steveed/a1200kb-external-case/docs/images/case-rear-db37.png

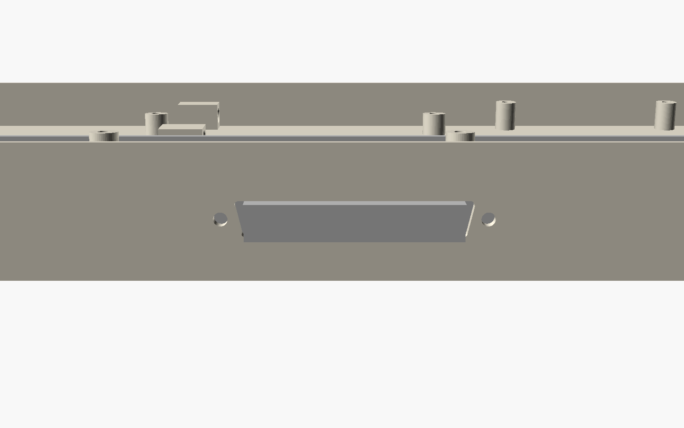
docs/images/case-rear-db37.png
