steveed/a1200kb-external-case/din5/fab/A1200KB-DIN5-bom.csv

Comment | Designator | Footprint | LCSC Part # | MPN
1uF | C1 | Capacitor_SMD:C_0603_1608Metric | C15849 | CL10A105KB8NNNC
100nF | C2 | Capacitor_SMD:C_0603_1608Metric | C14663 | CC0603KRX7R9BB104
PESD5V0S1BA | D1,D2 | Diode_SMD:D_SOD-323 | C19224 | PESD5V0S1BA,115
PTC 500mA hold | F1 | Fuse:Fuse_1206_3216Metric | C69688 | nSMD050
to A1200 CN17 | J1 | Connector_PinHeader_2.54mm:PinHeader_1x07_P2.54mm_Vertical | C492406 | PZ254V-11-07P
Amiga keyboard | J2 | A1200KB:DIN-5_180deg_DIN-504_Horizontal | C23689428 | DIN-504
220k | R1 | Resistor_SMD:R_0603_1608Metric | C22961 | 0603WAF2203T5E
1k | R2 | Resistor_SMD:R_0603_1608Metric | C21190 | 0603WAF1001T5E
74LVC1G14 | U1 | Package_TO_SOT_SMD:SOT-353_SC-70-5 | C265125 | 74LVC1G14GW,125
