steveed/a1200kb-external-case/encoder/fab/A1200KB-Encoder-bom.csv

Comment | Designator | Footprint | LCSC Part # | MPN
100nF | C1,C2,C3 | Capacitor_SMD:C_0603_1608Metric | C14663 | CC0603KRX7R9BB104
10uF | C4 | Capacitor_SMD:C_0805_2012Metric | C15850 | CL21A106KAYNNNE
PESD5V0S1BA | D1,D2 | Diode_SMD:D_SOD-323 | C19224 | PESD5V0S1BA,115
KB FFC | J1 | Amiga_FFC:FFC-1.25mm-RA-5204403245 |  | 52044-3245
LED HDR (symmetric) | J2 | Connector_PinHeader_2.54mm:PinHeader_1x05_P2.54mm_Horizontal | C32713264 | HX PZ2.54-1x5P WZ
Amiga keyboard | J3 | A1200KB:DIN-5_180deg_DIN-504_Horizontal | C23689428 | DIN-504
100 | R1,R2 | Resistor_SMD:R_0603_1608Metric | C22775 | 0603WAF1000T5E
10k | R3,R4 | Resistor_SMD:R_0603_1608Metric | C25804 | 0603WAF1002T5E
150 | R5 | Resistor_SMD:R_0603_1608Metric | C22808 | 0603WAF1500T5E
ATmega4809 | U1 | Package_QFP:TQFP-48_7x7mm_P0.5mm | C189475 | ATMEGA4809-AFR
