steveed/a1200kb-external-case/case/stl/tray_right.stl

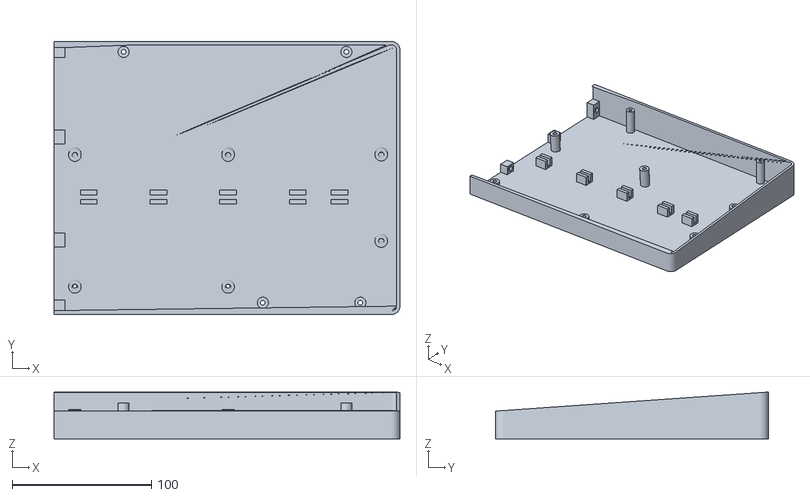
[picture p14: CAD file, 2026-10-28]
case/stl/tray_right.stl
248.5 x 195.9 x 33.7
