steveed/a1200kb-external-case/case/stl/lid_right.stl

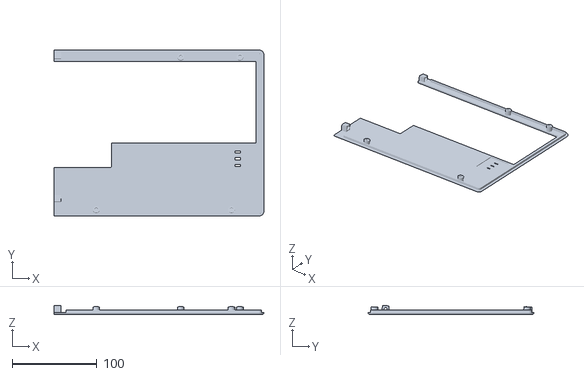
[picture p15: CAD file, 2026-10-28]
case/stl/lid_right.stl
248.5 x 196.4 x 10.9
