steveed/a1200kb-external-case/case/stl/tray_left-din5.stl

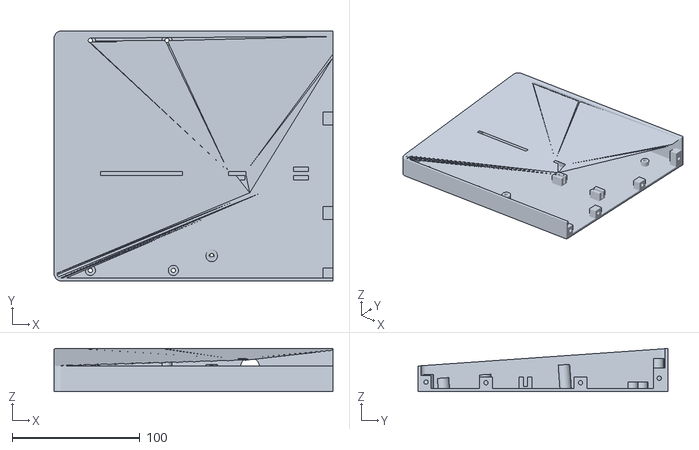
[picture p16: CAD file, 2026-10-28]
case/stl/tray_left-din5.stl
218.5 x 195.9 x 33.7
