steveed/a1200kb-external-case/case/stl/lid_left.stl

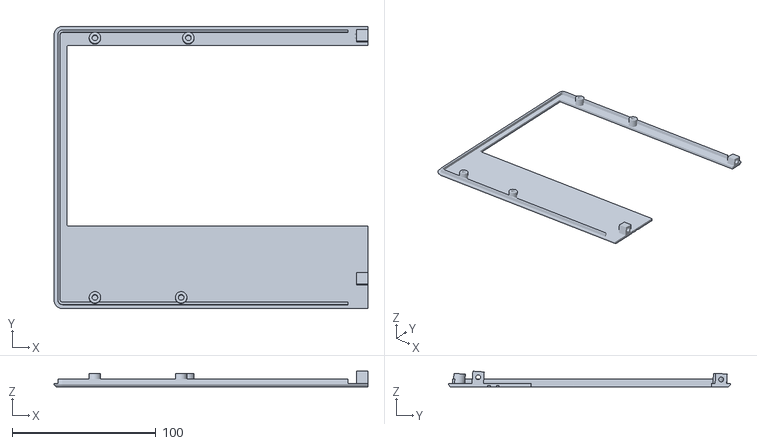
[picture p17: CAD file, 2026-10-28]
case/stl/lid_left.stl
218.5 x 196.4 x 10.9
