steveed/a1200kb-external-case/case/stl/spacers.stl

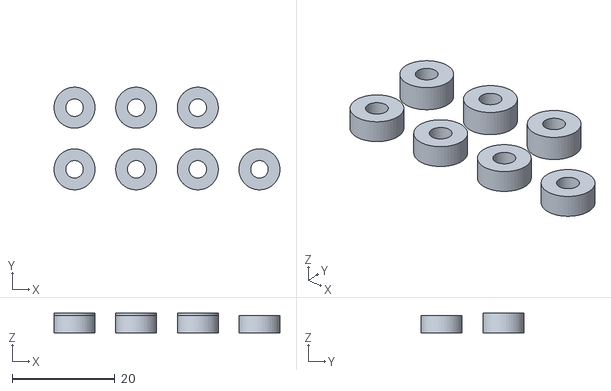
[picture p18: CAD file, 2026-10-28]
case/stl/spacers.stl
44.0 x 20.0 x 3.80
