steveed/a1200kb-external-case/case/kbv2-keys.scad

// A1200KBv2 keycaps: [x, y, width units, height units, iso] in the KBv2 PCB's KiCad coordinates.
// Generated from ../A1200KBv2/A1200KBv2.kicad_pcb (switch footprint positions and unit sizes); preview only.
kb_caps = [
    [81.91, 50.4, 1.25, 1, 0],   // K11
    [105.72, 50.51, 1.25, 1, 0],   // K17
    [153.47, 50.51, 1.25, 1, 0],   // K27
    [177.35, 50.51, 1.25, 1, 0],   // K33
    [209.86, 50.51, 1.25, 1, 0],   // K42
    [233.74, 50.51, 1.25, 1, 0],   // K51
    [257.61, 50.51, 1.25, 1, 0],   // K56
    [281.49, 50.51, 1.25, 1, 0],   // K62
    [305.37, 50.51, 1.25, 1, 0],   // K68
    [129.6, 50.54, 1.25, 1, 0],   // K22
    [50.86, 50.61, 1, 1, 0],   // K1
    [421.56, 79.07, 1, 1, 0],   // K79
    [440.61, 79.07, 1, 1, 0],   // K84
    [459.66, 79.07, 1, 1, 0],   // K88
    [478.71, 79.07, 1, 1, 0],   // K93
    [359.56, 79.11, 1.5, 1, 0],   // K74
    [388.15, 79.11, 1.5, 1, 0],   // K77
    [55.53, 79.17, 1.5, 1, 0],   // K2
    [79.31, 79.17, 1, 1, 0],   // K7
    [98.36, 79.17, 1, 1, 0],   // K13
    [117.41, 79.17, 1, 1, 0],   // K18
    [136.46, 79.17, 1, 1, 0],   // K23
    [155.51, 79.17, 1, 1, 0],   // K28
    [174.56, 79.17, 1, 1, 0],   // K34
    [193.61, 79.17, 1, 1, 0],   // K38
    [212.66, 79.17, 1, 1, 0],   // K43
    [231.71, 79.17, 1, 1, 0],   // K47
    [250.76, 79.17, 1, 1, 0],   // K52
    [269.81, 79.17, 1, 1, 0],   // K57
    [288.86, 79.17, 1, 1, 0],   // K63
    [307.91, 79.17, 1, 1, 0],   // K69
    [326.96, 79.17, 1, 1, 0],   // K72
    [421.56, 98.12, 1, 1, 0],   // K80
    [440.61, 98.12, 1, 1, 0],   // K85
    [459.66, 98.12, 1, 1, 0],   // K89
    [478.71, 98.12, 1, 1, 0],   // K94
    [60.26, 98.22, 2, 1, 0],   // K3
    [88.7, 98.22, 1, 1, 0],   // K8
    [107.75, 98.22, 1, 1, 0],   // K14
    [126.8, 98.22, 1, 1, 0],   // K19
    [145.85, 98.22, 1, 1, 0],   // K24
    [183.95, 98.22, 1, 1, 0],   // K35
    [203.0, 98.22, 1, 1, 0],   // K39
    [222.05, 98.22, 1, 1, 0],   // K44
    [241.1, 98.22, 1, 1, 0],   // K48
    [260.15, 98.22, 1, 1, 0],   // K53
    [279.2, 98.22, 1, 1, 0],   // K58
    [298.25, 98.22, 1, 1, 0],   // K64
    [164.9, 98.3, 1, 1, 0],   // K29
    [324.67, 107.87, 1.5, 2, 1],   // K71
    [421.56, 117.17, 1, 1, 0],   // K81
    [440.61, 117.17, 1, 1, 0],   // K86
    [459.66, 117.17, 1, 1, 0],   // K90
    [478.71, 117.17, 1, 1, 0],   // K95
    [373.88, 117.22, 1, 1, 0],   // K75
    [53.14, 117.27, 1.25, 1, 0],   // K4
    [74.48, 117.27, 1, 1, 0],   // K9
    [93.53, 117.27, 1, 1, 0],   // K15
    [112.58, 117.27, 1, 1, 0],   // K20
    [131.63, 117.27, 1, 1, 0],   // K25
    [150.68, 117.27, 1, 1, 0],   // K30
    [169.73, 117.27, 1, 1, 0],   // K36
    [188.78, 117.27, 1, 1, 0],   // K40
    [207.83, 117.27, 1, 1, 0],   // K45
    [226.88, 117.27, 1, 1, 0],   // K49
    [245.93, 117.27, 1, 1, 0],   // K54
    [265.23, 117.27, 1, 1, 0],   // K59
    [284.28, 117.27, 1, 1, 0],   // K65
    [303.33, 117.27, 1, 1, 0],   // K70
    [421.56, 136.22, 1, 1, 0],   // K82
    [440.61, 136.22, 1, 1, 0],   // K87
    [459.66, 136.22, 1, 1, 0],   // K91
    [354.83, 136.27, 1, 1, 0],   // K73
    [373.88, 136.27, 1, 1, 0],   // K76
    [392.93, 136.27, 1, 1, 0],   // K78
    [57.97, 136.32, 1.75, 1, 0],   // K5
    [84.13, 136.32, 1, 1, 0],   // K10
    [103.18, 136.32, 1, 1, 0],   // K16
    [122.23, 136.32, 1, 1, 0],   // K21
    [141.28, 136.32, 1, 1, 0],   // K26
    [160.33, 136.32, 1, 1, 0],   // K31
    [179.38, 136.32, 1, 1, 0],   // K37
    [198.43, 136.32, 1, 1, 0],   // K41
    [217.48, 136.32, 1, 1, 0],   // K46
    [236.54, 136.32, 1, 1, 0],   // K50
    [274.63, 136.32, 1, 1, 0],   // K60
    [310.45, 136.32, 2, 1, 0],   // K66
    [255.58, 136.34, 1, 1, 0],   // K55
    [478.71, 145.77, 1, 2, 0],   // K96
    [66.86, 155.37, 1.25, 1, 0],   // K6
    [90.74, 155.37, 1.25, 1, 0],   // K12
    [188.4, 155.37, 8, 1, 0],   // K32
    [286.06, 155.37, 1.25, 1, 0],   // K61
    [309.94, 155.37, 1.25, 1, 0],   // K67
    [431.21, 155.37, 2, 1, 0],   // K83
    [459.66, 155.37, 1, 1, 0]    // K92
];
