steveed/a1200kb-external-case/(list of files, cad)

Other CAD files:
case/stl/tray_left.stl
