steveed/a1200kb-external-case/case/stl/assembly.png

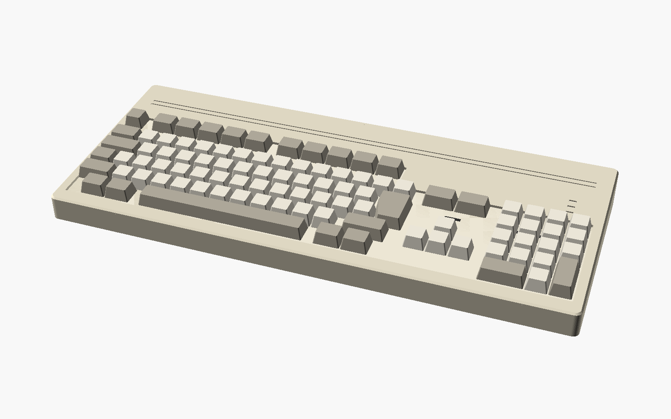
case/stl/assembly.png
