steveed/a1200kb-external-case/adapter/A1200KB-DB37.pdf

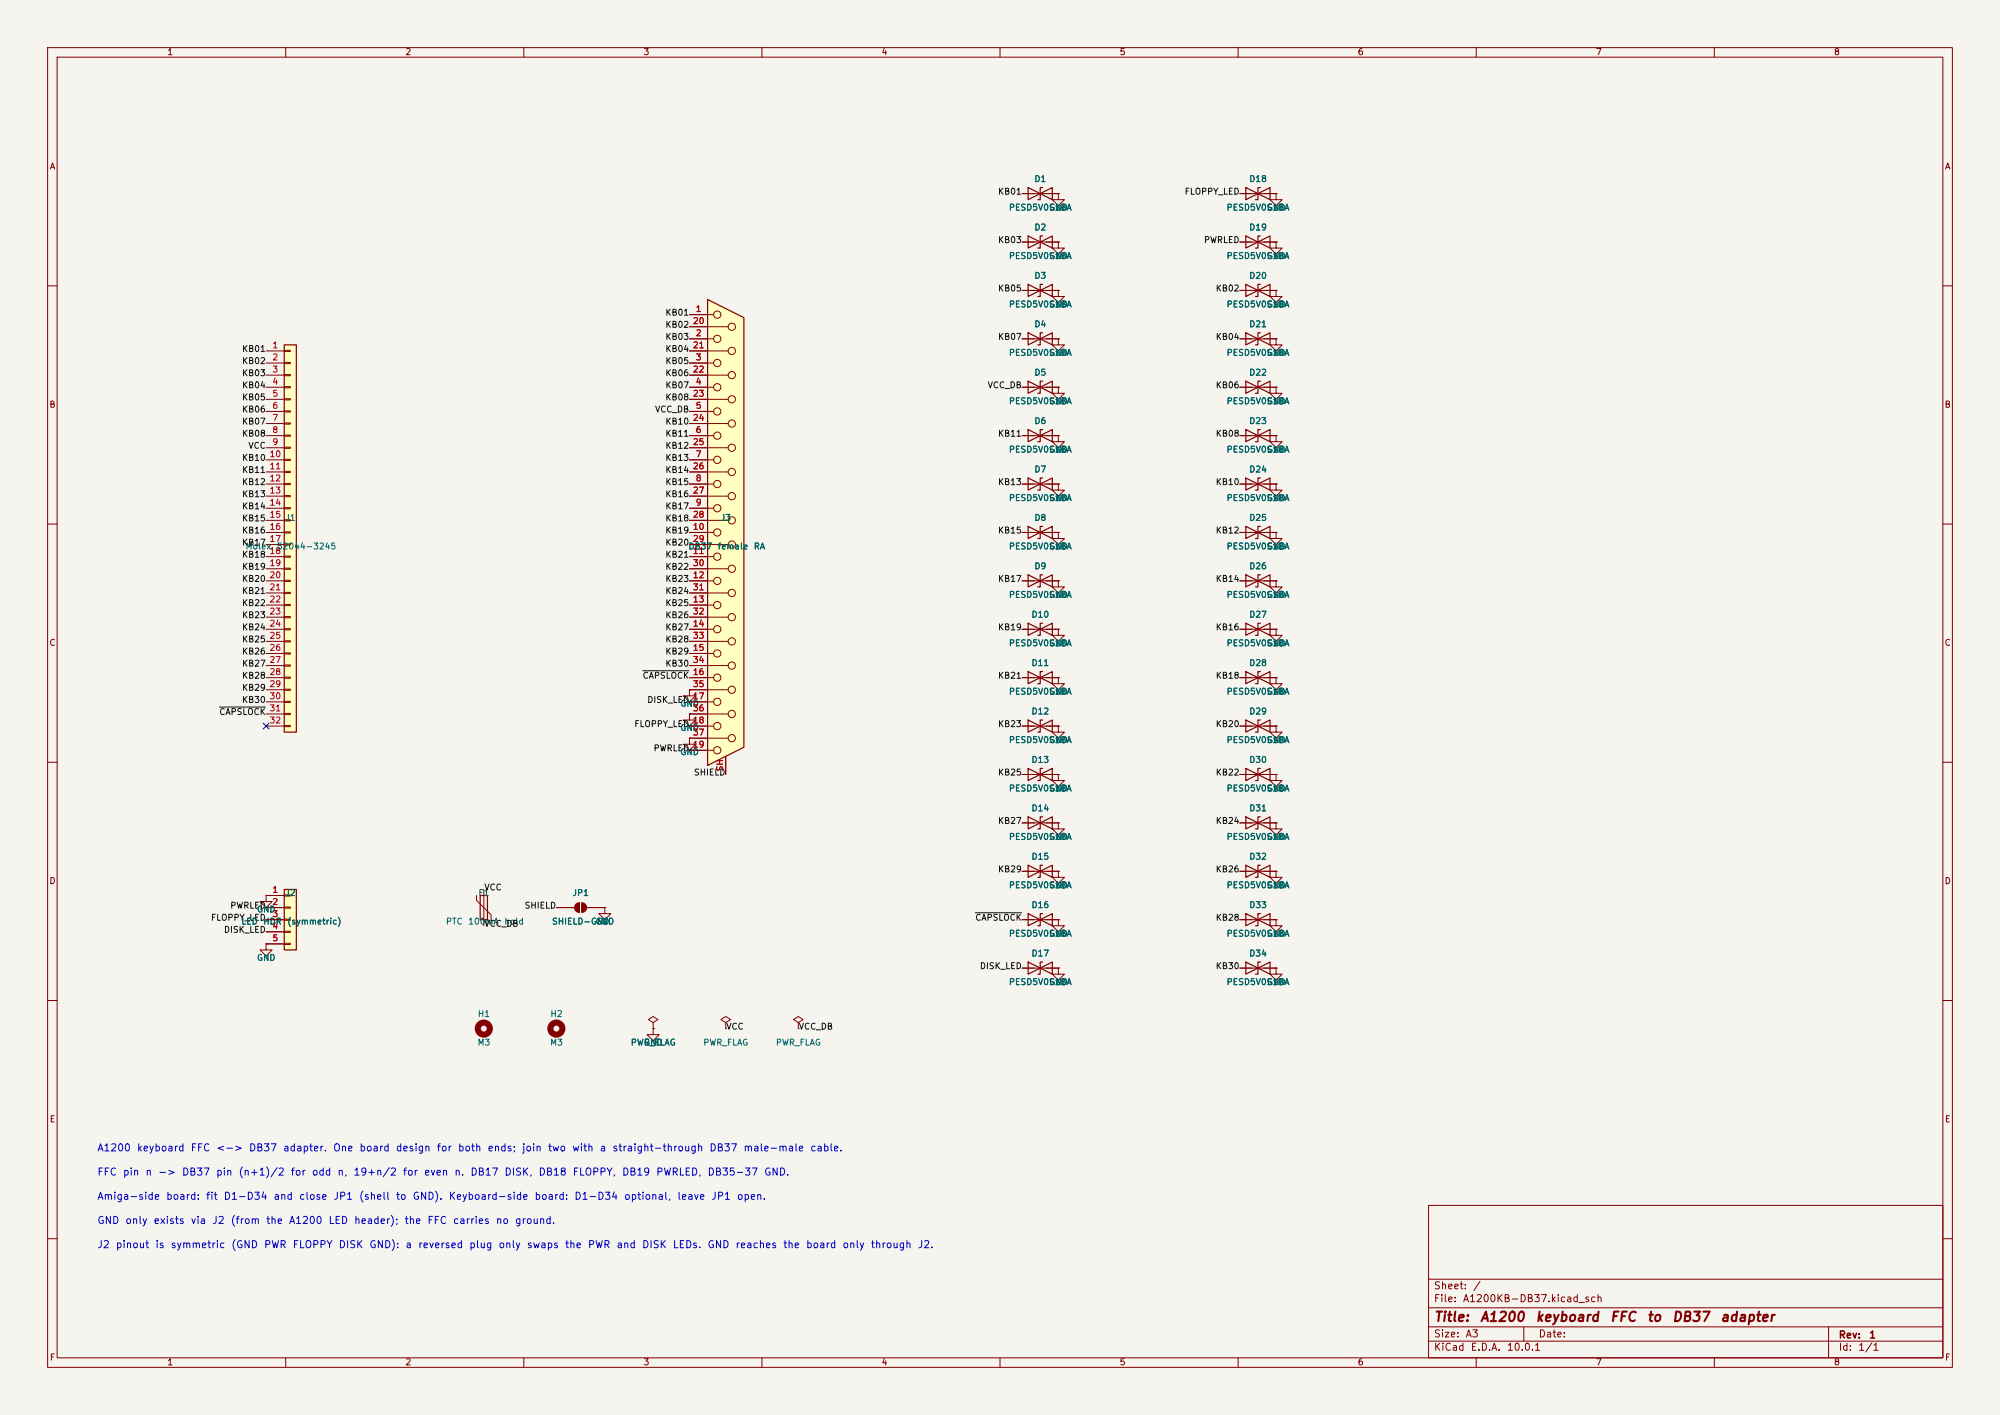
[picture p20: page 1]

FFC pin n -> DB37 pin (n+1)/2 for odd n, 19+n/2 for even n. DB17 DISK, DB18 FLOPPY, DB19 PWRLED, DB35-37 GND. JP1

Amiga-side board: fit D1-D34 and close JP1 (shell to GND). Keyboard-side board: D1-D34 optional, leave JP1 open.

GND only exists via J2 (from the A1200 LED header); the FFC carries no ground.

J2 pinout is symmetric (GND PWR FLOPPY DISK GND): a reversed plug only swaps the PWR and DISK LEDs. GND reaches the board only through J2.

Sheet: /
File: A1200KB-DB37.kicad_sch
Title: A1200 keyboard FFC to DB37 adapter

Size: A3 | Rev: 1 | F Date:
KiCad E.D.A. 10.0.1 | Id: 1/1
