steveed/a1200kb-external-case/adapter/A1200KB-DB37.kicad_pcb

## KiCad design adapter/A1200KB-DB37.kicad_pcb (2026-10-28)

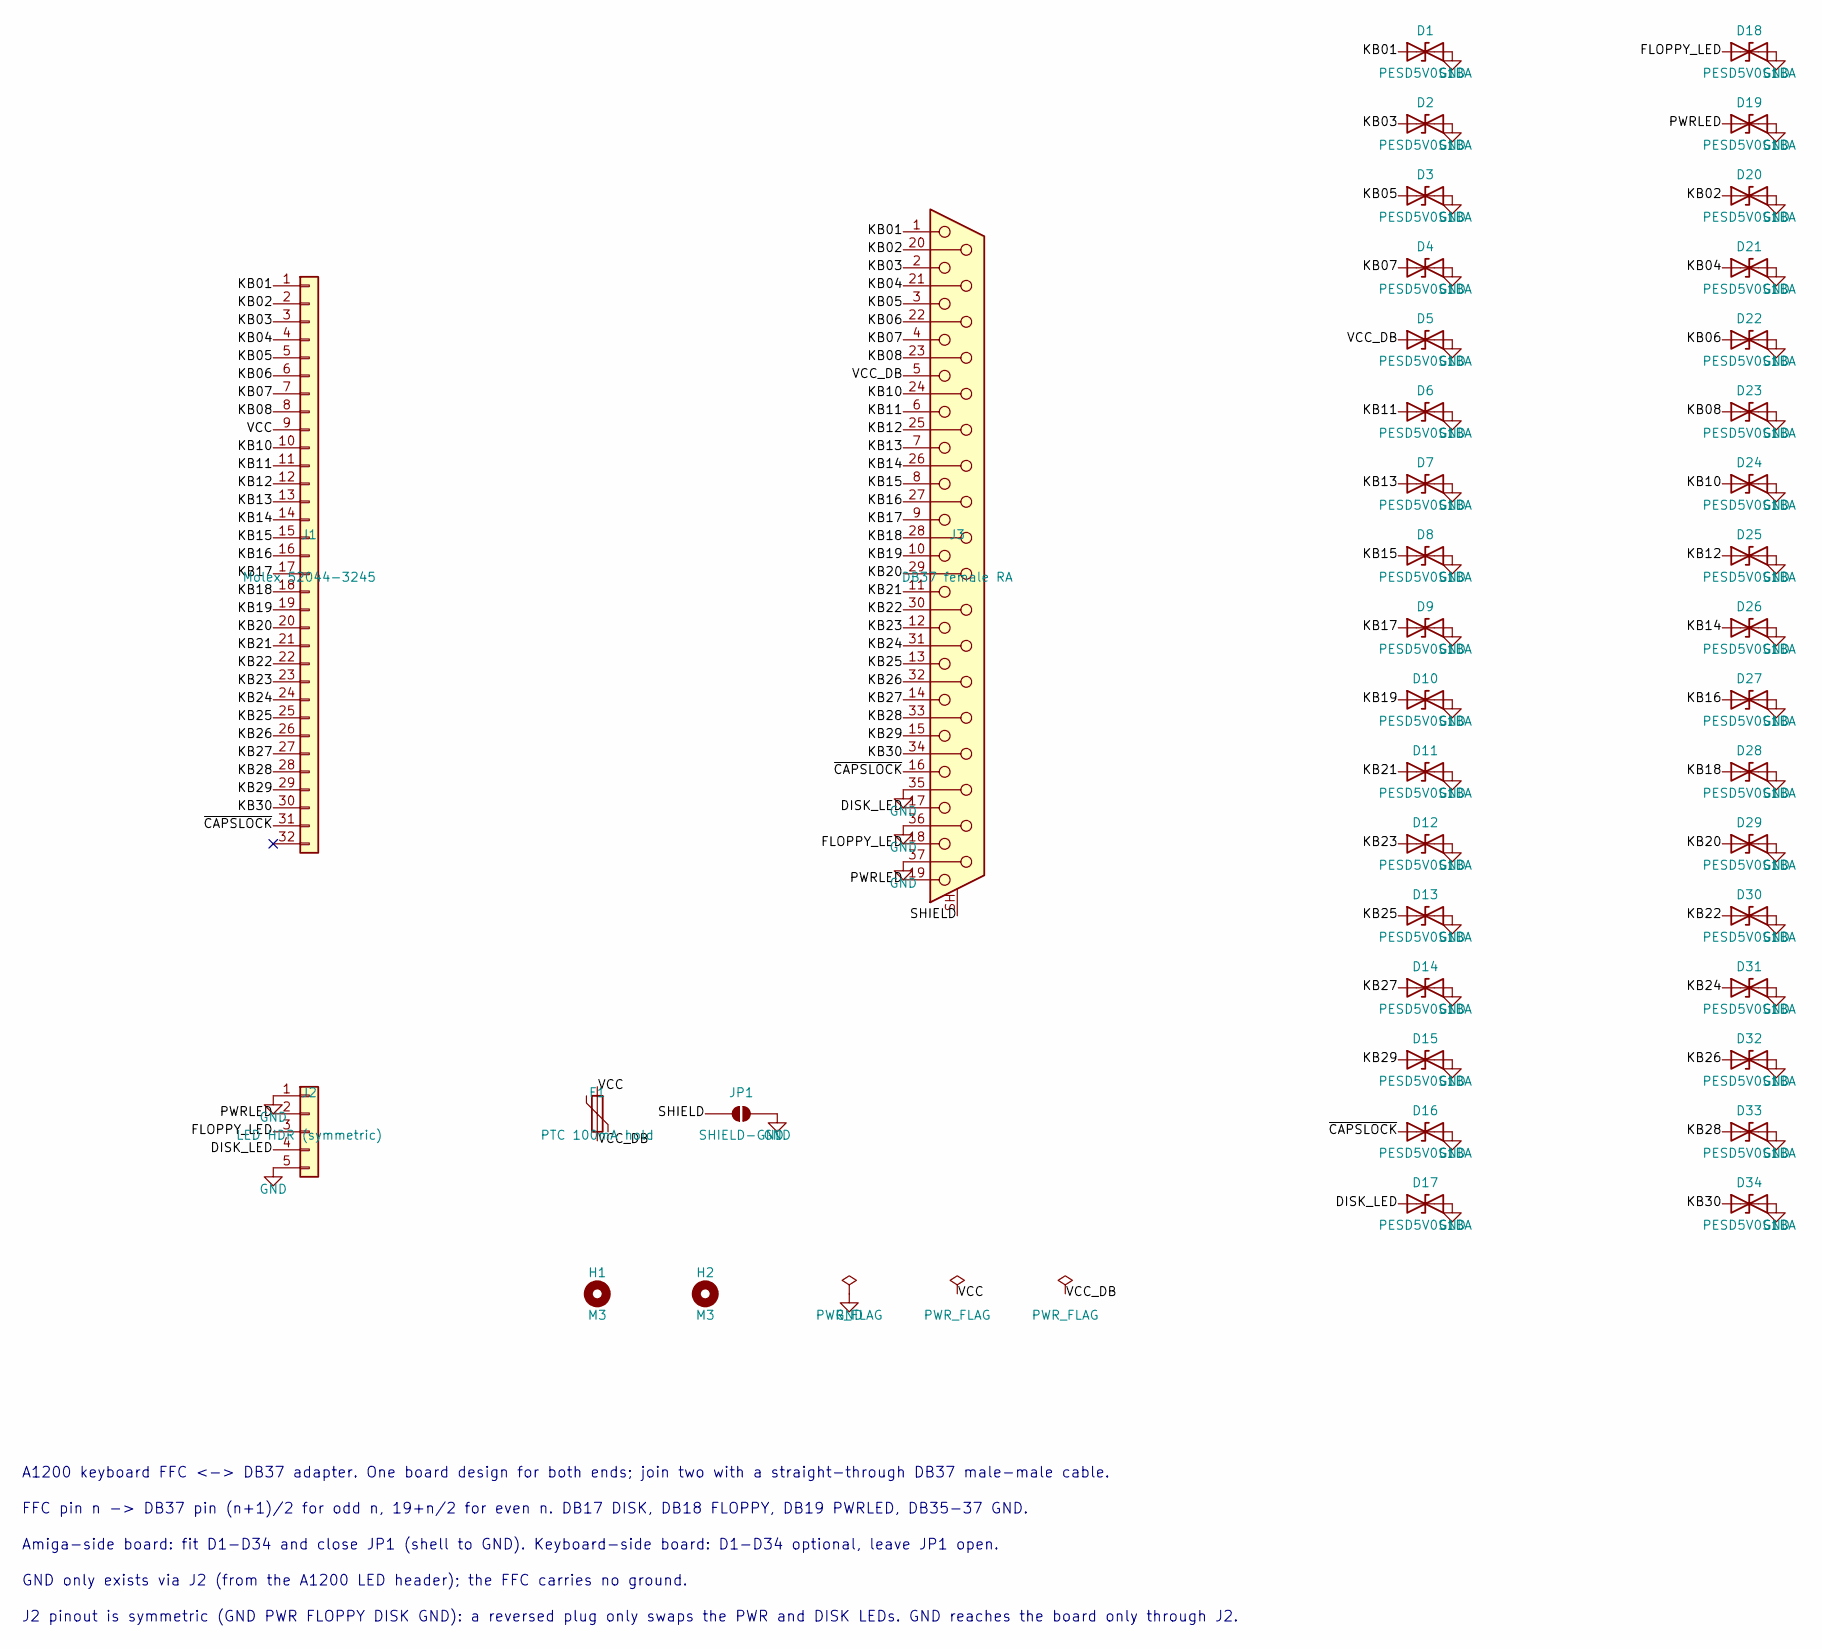
[picture p21: schematic A1200KB-DB37.kicad_sch, A1200 keyboard FFC to DB37 adapter]

Parts:
D1, D2, D3, D4, D5, D6, D7, D8, D9, D10, D11, D12, D13, D14, D15, D16, D17, D18, D19, D20, D21, D22, D23, D24, D25, D26, D27, D28, D29, D30, D31, D32, D33, D34: PESD5V0S1BA; D_SOD-323; MPN PESD5V0S1BA,115; LCSC C19224
F1: PTC 100mA hold; Fuse_1206_3216Metric; MPN nSMD010; LCSC C70065
H1, H2: M3; MountingHole_3.2mm_M3
J1: Molex 52044-3245; FFC-1.25mm-RA-5204403245; MPN 52044-3245
J2: LED HDR (symmetric); PinHeader_1x05_P2.54mm_Horizontal; MPN HX PZ2.54-1x5P WZ; LCSC C32713264
J3: DB37 female RA; DSUB-37_Socket_Horizontal_P2.77x2.84mm_EdgePinOffset7.70mm_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; MPN DS1037-37FNAKT74-0CC; LCSC C77839
JP1: SHIELD-GND; SolderJumper-2_P1.3mm_Open_RoundedPad1.0x1.5mm

Connections:
/DISK_LED: D17.1 (A1), J2.4, J3.17
/FLOPPY_LED: D18.1 (A1), J2.3, J3.18
/KB01: D1.1 (A1), J1.1, J3.1
/KB02: D20.1 (A1), J1.2, J3.20
/KB03: D2.1 (A1), J1.3, J3.2
/KB04: D21.1 (A1), J1.4, J3.21
/KB05: D3.1 (A1), J1.5, J3.3
/KB06: D22.1 (A1), J1.6, J3.22
/KB07: D4.1 (A1), J1.7, J3.4
/KB08: D23.1 (A1), J1.8, J3.23
/KB10: D24.1 (A1), J1.10, J3.24
/KB11: D6.1 (A1), J1.11, J3.6
/KB12: D25.1 (A1), J1.12, J3.25
/KB13: D7.1 (A1), J1.13, J3.7
/KB14: D26.1 (A1), J1.14, J3.26
/KB15: D8.1 (A1), J1.15, J3.8
/KB16: D27.1 (A1), J1.16, J3.27
/KB17: D9.1 (A1), J1.17, J3.9
/KB18: D28.1 (A1), J1.18, J3.28
/KB19: D10.1 (A1), J1.19, J3.10
/KB20: D29.1 (A1), J1.20, J3.29
/KB21: D11.1 (A1), J1.21, J3.11
/KB22: D30.1 (A1), J1.22, J3.30
/KB23: D12.1 (A1), J1.23, J3.12
/KB24: D31.1 (A1), J1.24, J3.31
/KB25: D13.1 (A1), J1.25, J3.13
/KB26: D32.1 (A1), J1.26, J3.32
/KB27: D14.1 (A1), J1.27, J3.14
/KB28: D33.1 (A1), J1.28, J3.33
/KB29: D15.1 (A1), J1.29, J3.15
/KB30: D34.1 (A1), J1.30, J3.34
/PWRLED: D19.1 (A1), J2.2, J3.19
/SHIELD: J3.SH (PAD), JP1.1 (A)
/VCC: F1.1, J1.9
/VCC_DB: D5.1 (A1), F1.2, J3.5
/~CAPSLOCK: D16.1 (A1), J1.31, J3.16
GND: D1.2 (A2), D2.2 (A2), D3.2 (A2), D4.2 (A2), D5.2 (A2), D6.2 (A2), D7.2 (A2), D8.2 (A2), D9.2 (A2), D10.2 (A2), D11.2 (A2), D12.2 (A2), D13.2 (A2), D14.2 (A2), D15.2 (A2), D16.2 (A2), D17.2 (A2), D18.2 (A2), D19.2 (A2), D20.2 (A2), D21.2 (A2), D22.2 (A2), D23.2 (A2), D24.2 (A2), D25.2 (A2), D26.2 (A2), D27.2 (A2), D28.2 (A2), D29.2 (A2), D30.2 (A2), D31.2 (A2), D32.2 (A2), D33.2 (A2), D34.2 (A2), J2.1, J2.5, J3.35, J3.36, J3.37, JP1.2 (B)

Notes on the sheet:
FFC pin n -> DB37 pin (n+1)/2 for odd n, 19+n/2 for even n. DB17 DISK, DB18 FLOPPY, DB19 PWRLED, DB35-37 GND.
Amiga-side board: fit D1-D34 and close JP1 (shell to GND). Keyboard-side board: D1-D34 optional, leave JP1 open.
GND only exists via J2 (from the A1200 LED header); the FFC carries no ground.
A1200 keyboard FFC <-> DB37 adapter. One board design for both ends; join two with a straight-through DB37 male-male cable.
J2 pinout is symmetric (GND PWR FLOPPY DISK GND): a reversed plug only swaps the PWR and DISK LEDs. GND reaches the board only through J2.

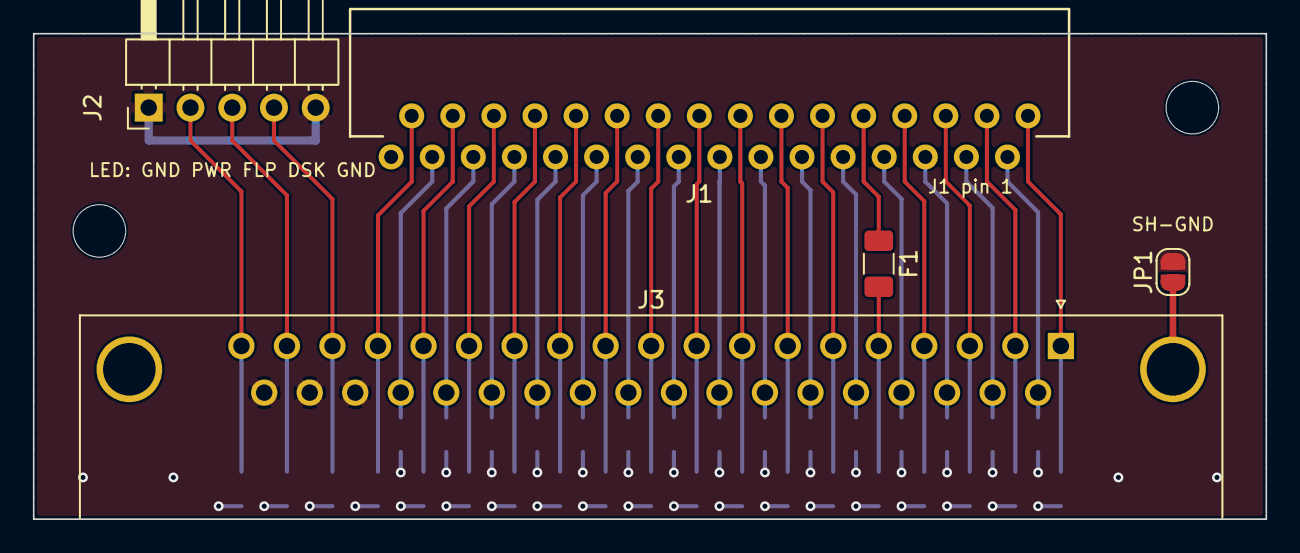
[picture p22: board A1200KB-DB37.kicad_pcb from above]

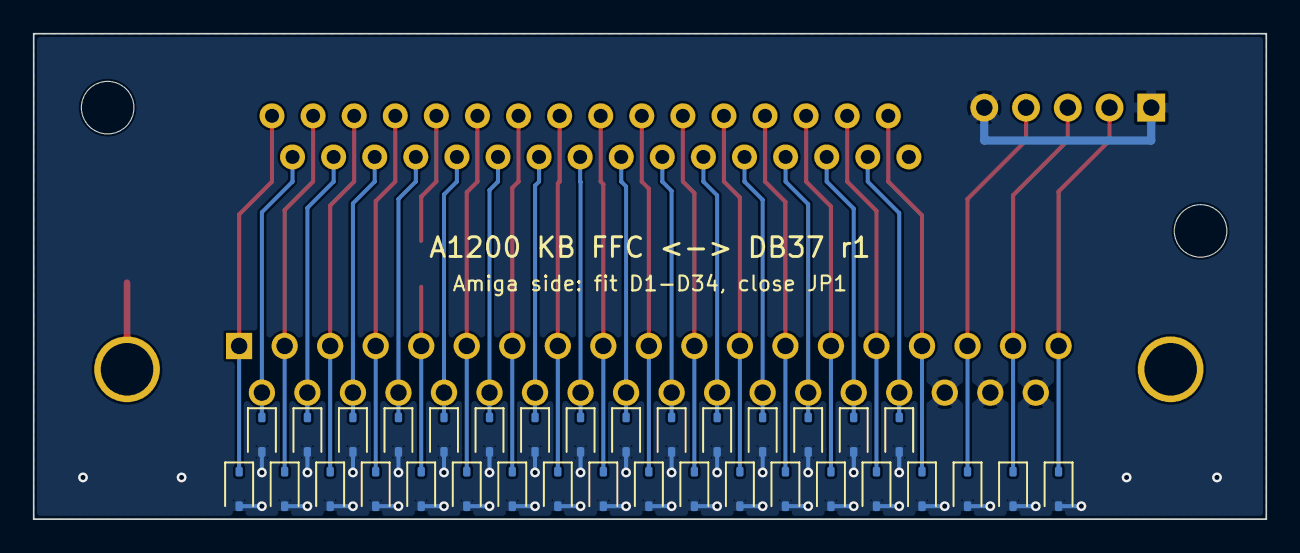
[picture p23: board A1200KB-DB37.kicad_pcb from below]

Board: 2 copper layers, 75.0 x 29.5 mm, 41 parts (34 on the bottom side), 37 nets.
