steveed/a1200kb-external-case/encoder/A1200KB-Encoder.kicad_pcb

## KiCad design encoder/A1200KB-Encoder.kicad_pcb (2026-10-28)

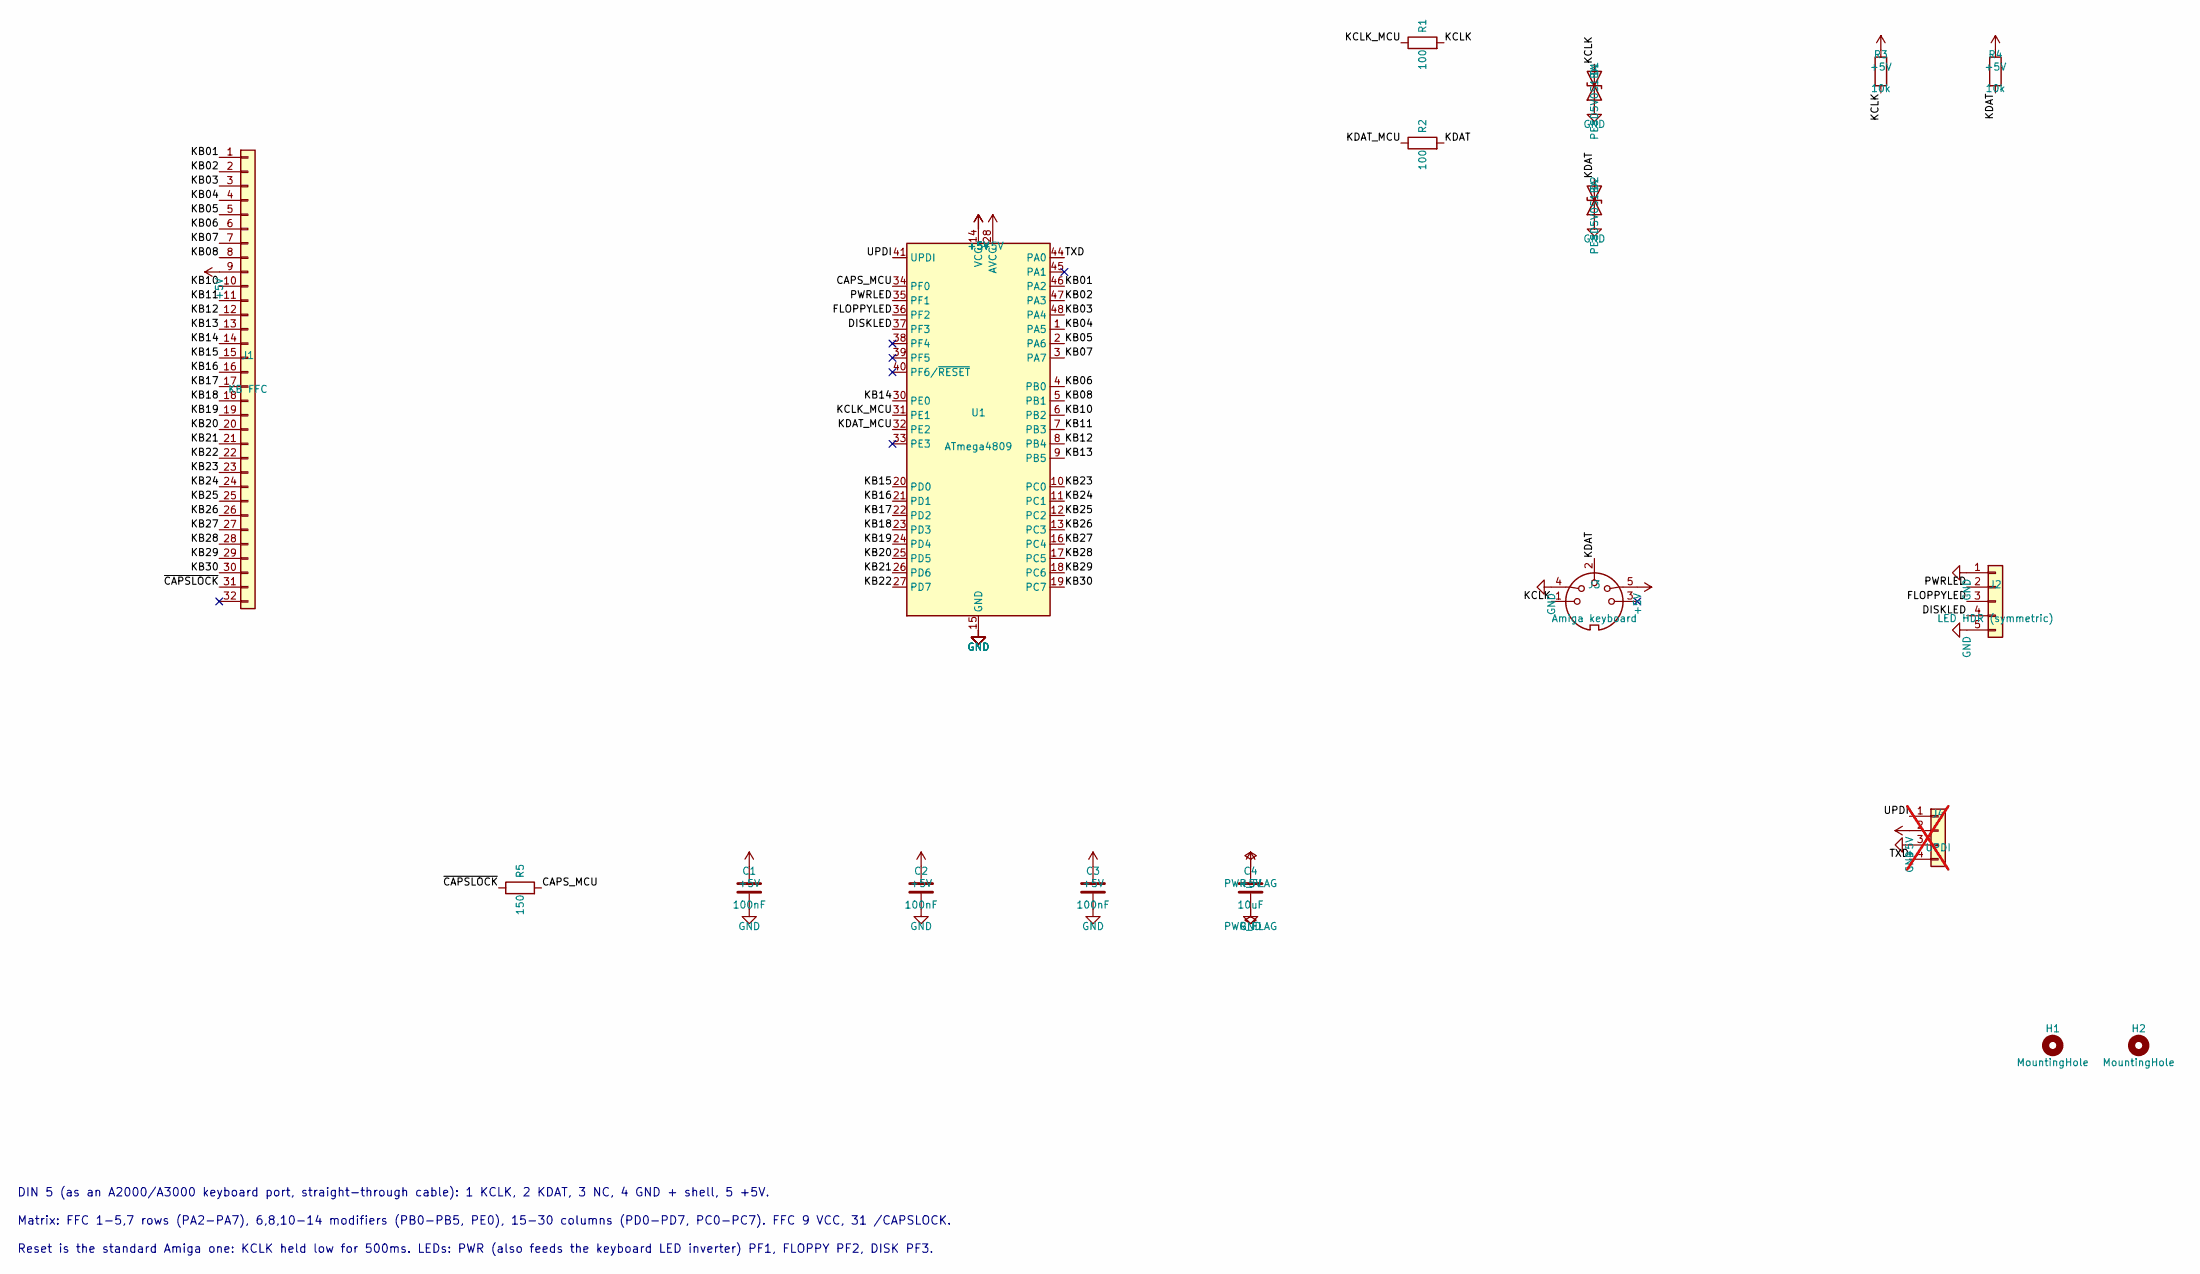
[picture p24: schematic A1200KB-Encoder.kicad_sch, A1200KBv2 matrix to standard Amiga keyboard (DIN 5)]

Parts:
C1, C2, C3: 100nF; C_0603_1608Metric; MPN CC0603KRX7R9BB104; LCSC C14663
C4: 10uF; C_0805_2012Metric; MPN CL21A106KAYNNNE; LCSC C15850
D1, D2: PESD5V0S1BA; D_SOD-323; MPN PESD5V0S1BA,115; LCSC C19224
H1, H2: MountingHole; MountingHole_3.2mm_M3
J1: KB FFC; FFC-1.25mm-RA-5204403245; MPN 52044-3245
J2: LED HDR (symmetric); PinHeader_1x05_P2.54mm_Horizontal; MPN HX PZ2.54-1x5P WZ; LCSC C32713264
J3: Amiga keyboard; DIN-5_180deg_DIN-504_Horizontal; MPN DIN-504; LCSC C23689428
J4: UPDI; PinHeader_1x04_P2.54mm_Vertical; not fitted
R1, R2: 100; R_0603_1608Metric; MPN 0603WAF1000T5E; LCSC C22775
R3, R4: 10k; R_0603_1608Metric; MPN 0603WAF1002T5E; LCSC C25804
R5: 150; R_0603_1608Metric; MPN 0603WAF1500T5E; LCSC C22808
U1: ATmega4809; TQFP-48_7x7mm_P0.5mm; MPN ATMEGA4809-AFR; LCSC C189475

Connections:
+5V: C1.1, C2.1, C3.1, C4.1, J1.9, J3.5, J4.2, R3.1, R4.1, U1.14 (VCC), U1.28 (AVCC), U1.42 (VCC)
/CAPS_MCU: R5.2, U1.34 (PF0)
/DISKLED: J2.4, U1.37 (PF3)
/FLOPPYLED: J2.3, U1.36 (PF2)
/KB01: J1.1, U1.46 (PA2)
/KB02: J1.2, U1.47 (PA3)
/KB03: J1.3, U1.48 (PA4)
/KB04: J1.4, U1.1 (PA5)
/KB05: J1.5, U1.2 (PA6)
/KB06: J1.6, U1.4 (PB0)
/KB07: J1.7, U1.3 (PA7)
/KB08: J1.8, U1.5 (PB1)
/KB10: J1.10, U1.6 (PB2)
/KB11: J1.11, U1.7 (PB3)
/KB12: J1.12, U1.8 (PB4)
/KB13: J1.13, U1.9 (PB5)
/KB14: J1.14, U1.30 (PE0)
/KB15: J1.15, U1.20 (PD0)
/KB16: J1.16, U1.21 (PD1)
/KB17: J1.17, U1.22 (PD2)
/KB18: J1.18, U1.23 (PD3)
/KB19: J1.19, U1.24 (PD4)
/KB20: J1.20, U1.25 (PD5)
/KB21: J1.21, U1.26 (PD6)
/KB22: J1.22, U1.27 (PD7)
/KB23: J1.23, U1.10 (PC0)
/KB24: J1.24, U1.11 (PC1)
/KB25: J1.25, U1.12 (PC2)
/KB26: J1.26, U1.13 (PC3)
/KB27: J1.27, U1.16 (PC4)
/KB28: J1.28, U1.17 (PC5)
/KB29: J1.29, U1.18 (PC6)
/KB30: J1.30, U1.19 (PC7)
/KCLK: D1.2 (A2), J3.1, R1.2, R3.2
/KCLK_MCU: R1.1, U1.31 (PE1)
/KDAT: D2.2 (A2), J3.2, R2.2, R4.2
/KDAT_MCU: R2.1, U1.32 (PE2)
/PWRLED: J2.2, U1.35 (PF1)
/TXD: J4.4, U1.44 (PA0)
/UPDI: J4.1, U1.41 (UPDI)
/~CAPSLOCK: J1.31, R5.1
GND: C1.2, C2.2, C3.2, C4.2, D1.1 (A1), D2.1 (A1), J2.1, J2.5, J3.4, J4.3, U1.15 (GND), U1.29 (GND), U1.43 (GND)

Notes on the sheet:
DIN 5 (as an A2000/A3000 keyboard port, straight-through cable): 1 KCLK, 2 KDAT, 3 NC, 4 GND + shell, 5 +5V.
Matrix: FFC 1-5,7 rows (PA2-PA7), 6,8,10-14 modifiers (PB0-PB5, PE0), 15-30 columns (PD0-PD7, PC0-PC7). FFC 9 VCC, 31 /CAPSLOCK.
Reset is the standard Amiga one: KCLK held low for 500ms. LEDs: PWR (also feeds the keyboard LED inverter) PF1, FLOPPY PF2, DISK PF3.

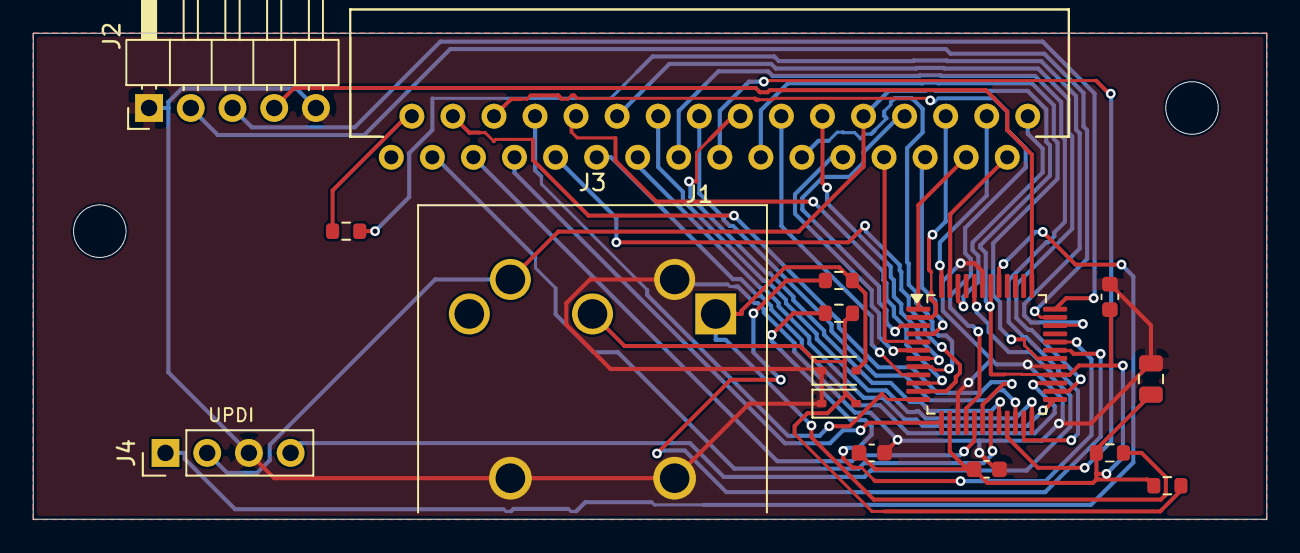
[picture p25: board A1200KB-Encoder.kicad_pcb from above]

Board: 2 copper layers, 75.1 x 29.6 mm, 18 parts (0 on the bottom side), 42 nets.
