steveed/a1200kb-external-case/din5/A1200KB-DIN5.kicad_pcb

## KiCad design din5/A1200KB-DIN5.kicad_pcb (2026-10-28)

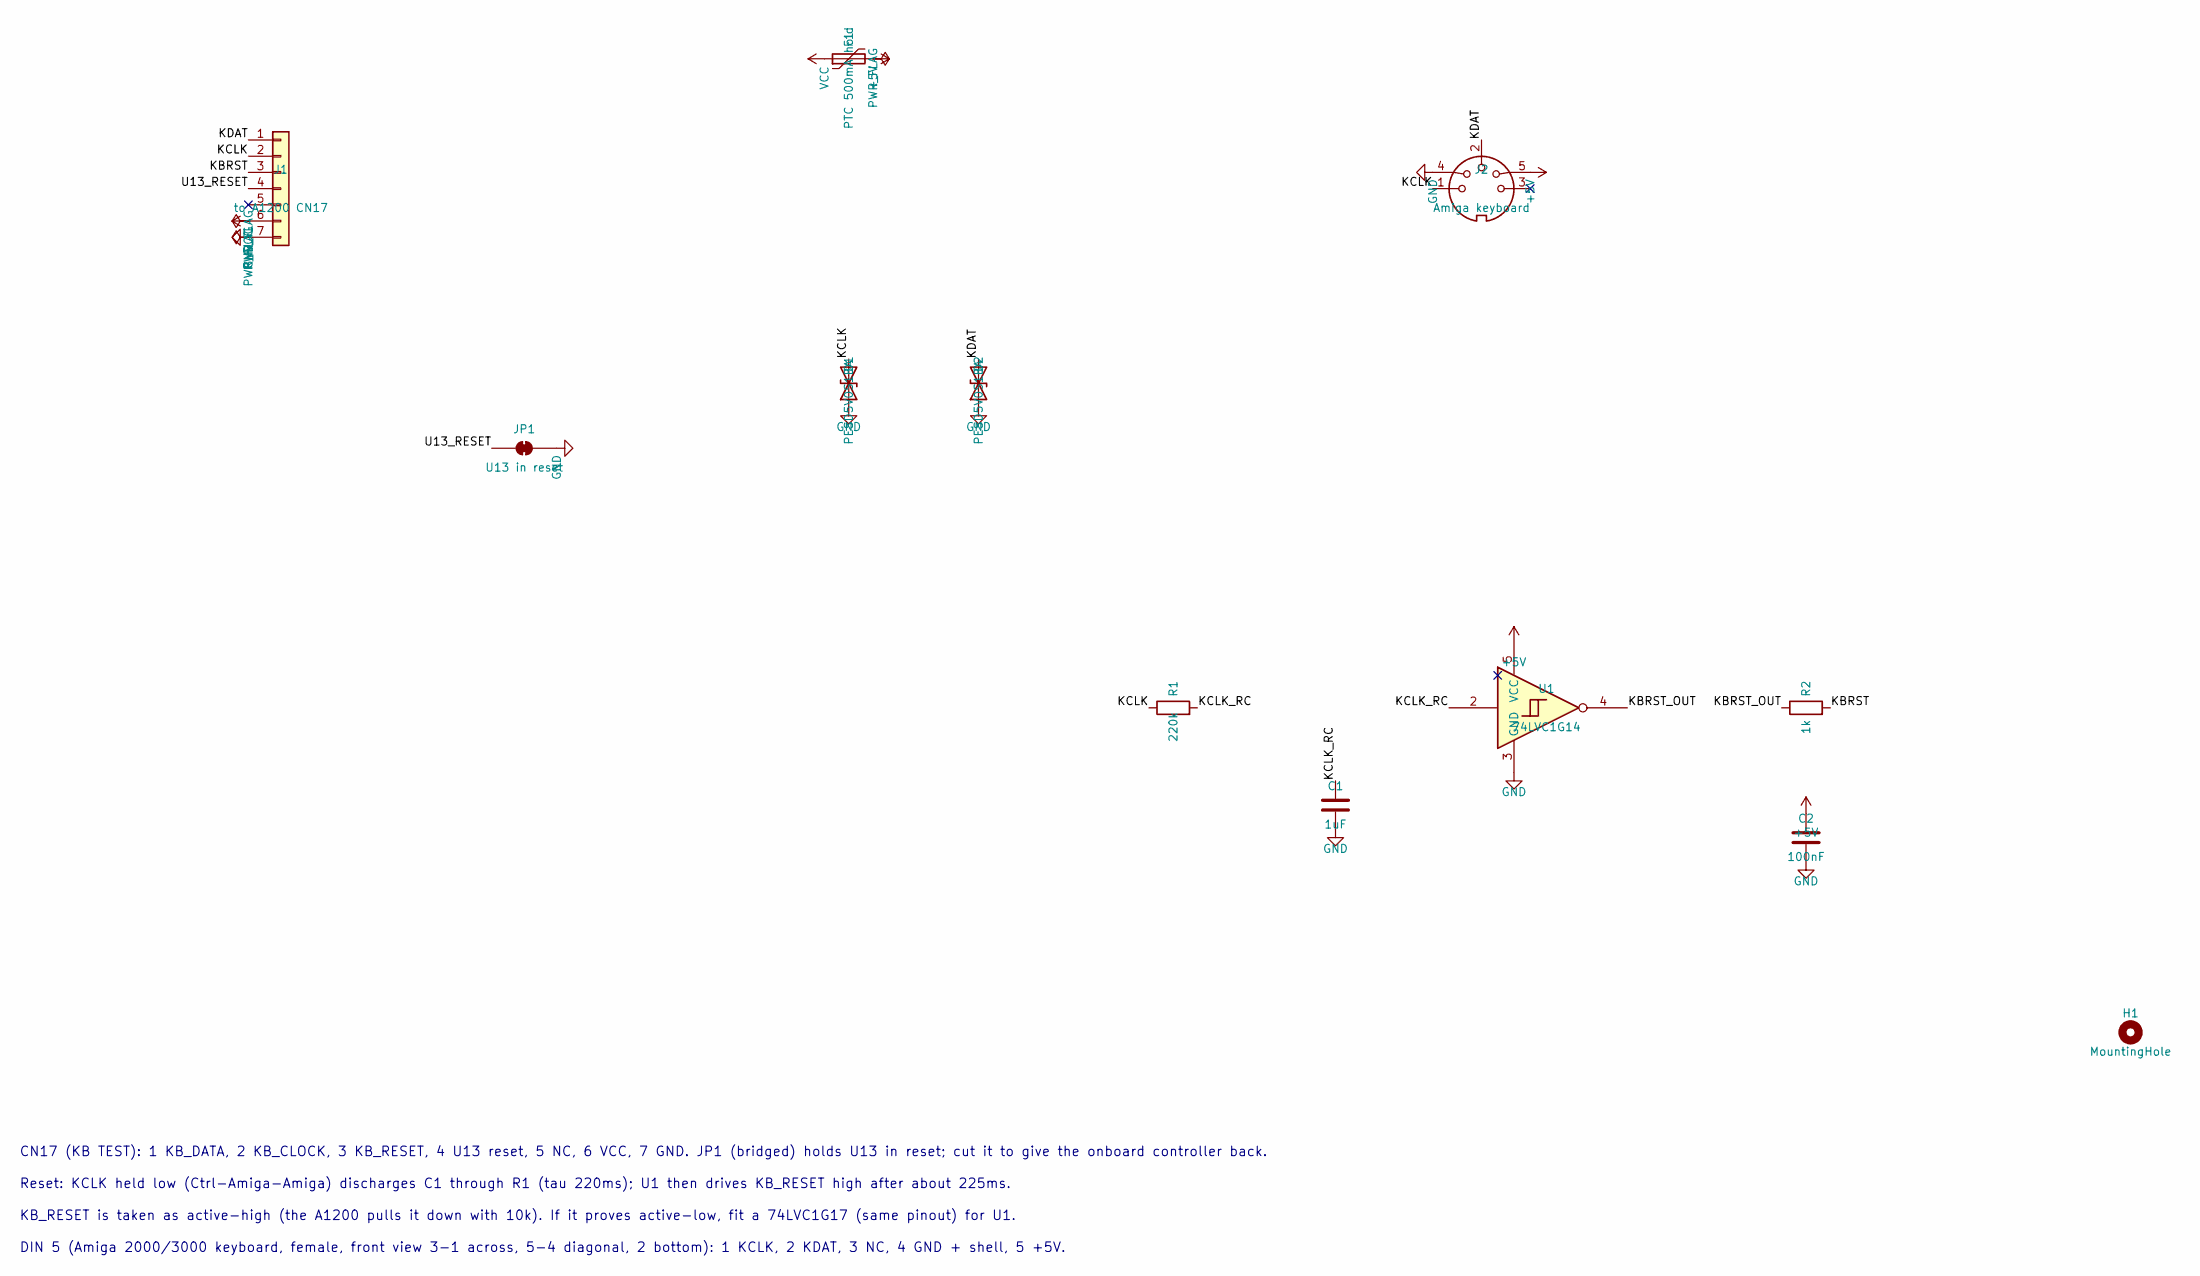
[picture p26: schematic A1200KB-DIN5.kicad_sch, A1200 CN17 to standard Amiga 5-pin DIN keyboard socket]

Parts:
C1: 1uF; C_0603_1608Metric; MPN CL10A105KB8NNNC; LCSC C15849
C2: 100nF; C_0603_1608Metric; MPN CC0603KRX7R9BB104; LCSC C14663
D1, D2: PESD5V0S1BA; D_SOD-323; MPN PESD5V0S1BA,115; LCSC C19224
F1: PTC 500mA hold; Fuse_1206_3216Metric; MPN nSMD050; LCSC C69688
H1: MountingHole; MountingHole_3.2mm_M3
J1: to A1200 CN17; PinHeader_1x07_P2.54mm_Vertical; MPN PZ254V-11-07P; LCSC C492406
J2: Amiga keyboard; DIN-5_180deg_DIN-504_Horizontal; MPN DIN-504; LCSC C23689428
JP1: U13 in reset; SolderJumper-2_P1.3mm_Bridged_RoundedPad1.0x1.5mm
R1: 220k; R_0603_1608Metric; MPN 0603WAF2203T5E; LCSC C22961
R2: 1k; R_0603_1608Metric; MPN 0603WAF1001T5E; LCSC C21190
U1: 74LVC1G14; SOT-353_SC-70-5; MPN 74LVC1G14GW,125; LCSC C265125

Connections:
+5V: C2.1, F1.2, J2.5, U1.5 (VCC)
/KBRST: J1.3, R2.2
/KBRST_OUT: R2.1, U1.4
/KCLK: D1.2 (A2), J1.2, J2.1, R1.1
/KCLK_RC: C1.1, R1.2, U1.2
/KDAT: D2.2 (A2), J1.1, J2.2
/U13_RESET: J1.4, JP1.1 (A)
GND: C1.2, C2.2, D1.1 (A1), D2.1 (A1), J1.7, J2.4, JP1.2 (B), U1.3 (GND)
VCC: F1.1, J1.6

Notes on the sheet:
CN17 (KB TEST): 1 KB_DATA, 2 KB_CLOCK, 3 KB_RESET, 4 U13 reset, 5 NC, 6 VCC, 7 GND. JP1 (bridged) holds U13 in reset; cut it to give the onboard controller back.
Reset: KCLK held low (Ctrl-Amiga-Amiga) discharges C1 through R1 (tau 220ms); U1 then drives KB_RESET high after about 225ms.
KB_RESET is taken as active-high (the A1200 pulls it down with 10k). If it proves active-low, fit a 74LVC1G17 (same pinout) for U1.
DIN 5 (Amiga 2000/3000 keyboard, female, front view 3-1 across, 5-4 diagonal, 2 bottom): 1 KCLK, 2 KDAT, 3 NC, 4 GND + shell, 5 +5V.

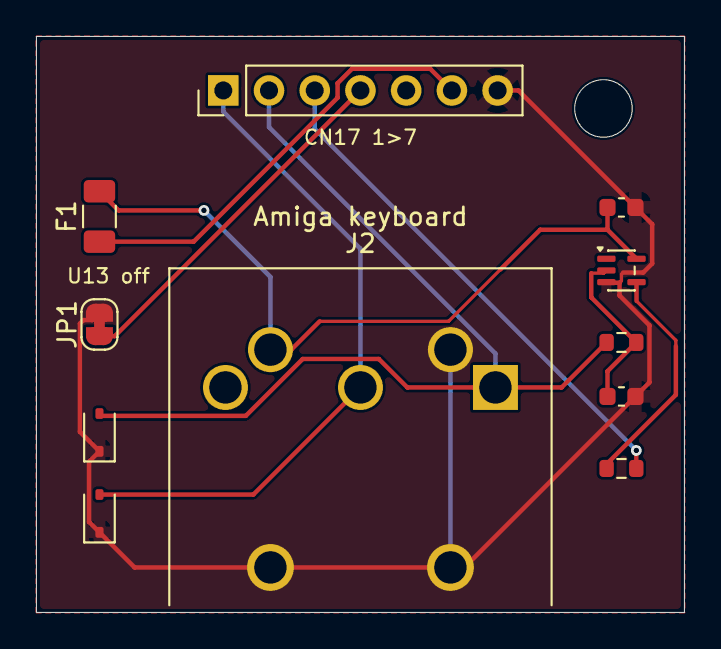
[picture p27: board A1200KB-DIN5.kicad_pcb from above]

Board: 2 copper layers, 36.0 x 32.0 mm, 12 parts (0 on the bottom side), 9 nets.
