steveed/a1200kb-external-case/(commit log)

2026-10-27 add ffc to db37 adapter board, rev 1.
    [A1200KB-DB37-B_Cu.gbr, A1200KB-DB37-B_Mask.gbr, A1200KB-DB37-B_Paste.gbr, A1200KB-DB37-B_Silkscreen.gbr, A1200KB-DB37-Edge_Cuts.gbr, A1200KB-DB37-F_Cu.gbr, A1200KB-DB37-F_Mask.gbr, A1200KB-DB37-F_Paste.gbr]
2026-10-27 ignore kicad local history.
2026-10-27 add floppy power header for ground, move h1 to make room.
    [A1200KB-DB37-B_Cu.gbr, A1200KB-DB37-B_Mask.gbr, A1200KB-DB37-B_Paste.gbr, A1200KB-DB37-B_Silkscreen.gbr, A1200KB-DB37-Edge_Cuts.gbr, A1200KB-DB37-F_Cu.gbr, A1200KB-DB37-F_Mask.gbr, A1200KB-DB37-F_Paste.gbr]
2026-10-27 replace floppy header with symmetric 5-pin led header for safe reversal.
    [A1200KB-DB37-B_Cu.gbr, A1200KB-DB37-B_Mask.gbr, A1200KB-DB37-B_Paste.gbr, A1200KB-DB37-B_Silkscreen.gbr, A1200KB-DB37-Edge_Cuts.gbr, A1200KB-DB37-F_Cu.gbr, A1200KB-DB37-F_Mask.gbr, A1200KB-DB37-F_Paste.gbr]
2026-10-27 refit db37 edge offset to suit the sockets lcsc actually stocks.
    [A1200KB-DB37-B_Cu.gbr, A1200KB-DB37-B_Mask.gbr, A1200KB-DB37-B_Paste.gbr, A1200KB-DB37-B_Silkscreen.gbr, A1200KB-DB37-Edge_Cuts.gbr, A1200KB-DB37-F_Cu.gbr, A1200KB-DB37-F_Mask.gbr, A1200KB-DB37-F_Paste.gbr]
2026-10-27 add lcsc part numbers and jlc bom/cpl export for assembly.
    [A1200KB-DB37-bom.csv, A1200KB-DB37.kicad_pcb, A1200KB-DB37.kicad_sch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]
2026-10-28 let the jlc export script take any board, and warn about cn14 led wiring.
2026-10-28 add a printable two-piece wedge case for the keyboard and rear board.
    [a1200kb-case.scad, kbv2-keys.scad, lid_left.stl, lid_right.stl, spacers.stl, tray_left-din5.stl, tray_left.stl, tray_right.stl]
2026-10-28 add an encoder and a cn17 din 5 socket so the keyboard works as a standard amiga keyboard.
    [A1200KB-DIN5-B_Cu.gbl, A1200KB-DIN5-B_Mask.gbs, A1200KB-DIN5-B_Paste.gbp, A1200KB-DIN5-B_Silkscreen.gbo, A1200KB-DIN5-Edge_Cuts.gm1, A1200KB-DIN5-F_Cu.gtl, A1200KB-DIN5-F_Mask.gts, A1200KB-DIN5-F_Paste.gtp]
2026-10-28 give the ffc socket a 3d model so the adapter renders show it.
    [A1200KB-DB37.kicad_pcb]
2026-10-28 add a setup guide with wiring diagrams and renders of the boards and case.
    [scene.scad]
2026-10-28 document the controller-board setup and a u13 clip for boards without cn17.
